chrisdoble/self-balancing-inverted-pendulum/post/post.pdf

# How I Made a Self-Balancing Inverted Pendulum

Chris Doble
chris@chrisdoble.com

February 2024

## Contents

1 Introduction | 1
2 Equations of Motion | 2
3 Linearisation | 5
4 Stability | 7
5 Control | 7
6 Construction | 9
7 Motor Control | 11
8 Code | 16
9 Conclusion | 16

## 1 Introduction

I recently built a self-balancing inverted pendulum. You can watch a video of it here. (https://www.youtube.com/watch?v=-cd6RuVWI30) If you’ve ever tried to keep something like a broom or a stick upright on your hand you’ll know it can be quite tricky! Gravity’s constantly pulling it down, so if it’s not perfectly vertical it’ll start to fall. The same thing happens to the pendulum but it’s connected to a cart which is programmed to move left and right in a way that keeps the pendulum upright.
In this document I’ll explain how I built it. We’ll start by deriving the system’s equations of motion, then we’ll linearise them so we can make use of some tools from linear control theory. Those tools will help us determine if the system is stable and how to control it. We’ll talk about the physical construction of the system and how that integrates with the mathematical model. Finally we’ll talk about the code that controls it.

1

## 2 Equations of Motion

If we want to control this system we need to know how it behaves, so let’s derive its equations of motion. First we need to define our coordinate system and variables in a diagram:

x
m1

m2

l

θ

x

y

We have a cart of mass m1. Its x position is measured from some origin point and it can only move along the x-axis. The cart is connected to a simple pendulum of length l and mass m2 and it’s at an angle θ from vertical.
With that out of the way, now we can calculate the Lagrangian of the system. The Lagrangian is defined as the difference between the system’s kinetic and potential energies
L = T − U.

Starting with the cart, its kinetic energy is

Tcart =

1
2

m1v

2

but because it can only move along the x-axis its velocity has no y component and this is equivalent to

Tcart =

1
2

m1x˙

2

where ˙x is the derivative of x with respect to time, i.e. the cart’s x velocity. As for the cart’s potential energy, it can’t move up or down so its gravitational potential energy can’t change and there’s no springs or anything involved so we might as well set it to
Ucart = 0.

Next, the pendulum. Because it’s joined to the cart its x coordinate changes as the cart moves, and both of its coordinates change as it rotates. That being the case, its coordinates are

X = x − lsin θ
Y = l cos θ.

2

Differentiating them with respect to time gives the x and y components of the pendulum’s velocity

X˙ = ˙x − l

˙θ cos θ

Y˙ = −l

˙θ sin θ.

Using the Pythagorean theorem we can combine these to find the squared mag-nitude of its velocity

V

2 = X˙ 2 + Y˙ 2

= ( ˙x − l

˙θ cos θ)
2 + (−l

˙θ sin θ)
2

= ˙x

2 − 2l

˙θx˙ cos θ + l
2 ˙θ
2

and we can use this to find its kinetic energy

Tpendulum =

1
2

m2V

2

=

1
2

m2( ˙x

2 − 2l

˙θx˙ cos θ + l

2 ˙θ
2
).

Unlike the cart, the pendulum’s potential energy can change — when it rotates it moves up and down so its gravitational potential energy changes. If we say its potential energy is 0 when it’s horizontal (θ = π/2), then we can define its potential energy to be

Upendulum = m2gy
= m2gl cos θ

where g is acceleration due to gravity.
Combining all of those energies and rearranging gives us our Lagrangian

L = T − U

= Tcart + Tpendulum − Ucart − Upendulum

=

1
2

m1x˙

2 +

1
2

m2( ˙x

2 − 2l

˙θx˙ cos θ + l

2 ˙θ
2
) − m2gl cos θ

=

1
2

(m1 + m2) ˙x

2 +

1
2

m2(l

2 ˙θ
2 − 2l

˙θx˙ cos θ) − m2gl cos θ.

Now that we have it we can apply the Euler-Lagrange equation to each of the system’s two coordinates θ and x. For θ we get

0 =

∂L
∂θ −

d
dt

∂L
∂ ˙θ

= m2l

˙θx˙ sin θ + m2glsin θ −

d
dt(m2l

2 ˙θ − m2lx˙ cos θ)

= m2l

˙θx˙ sin θ + m2glsin θ − m2l

2 ¨θ + m2lx¨ cos θ − m2l

˙θx˙ sin θ

= g sin θ − l

¨θ + ¨x cos θ

3

and for x we get

0 =

∂L
∂x −

d
dt

∂L
∂x˙

= −

d
dt[(m1 + m2) ˙x − m2l

˙θ cos θ]

= −(m1 + m2)¨x + m2l

¨θ cos θ − m2l

˙θ
2
sin θ.

Rearranging these two equations and solving for ¨θ and ¨x gives us our equations of motion

¨θ =

(m1 + m2)g sin θ − m2l

˙θ
2
cos θ sin θ
l(m1 + m2) − m2l cos² θ

x¨ =

m2g sin 2θ − 2m2l

˙θ
2
sin θ
2m1 + m2 − m2 cos 2θ

Now that we have them how do we know they’re correct? One way would be to solve them for θ and x and see if their predictions are reasonable. I certainly don’t know how to solve them analytically, but we can solve them numerically. Here (https://github.com/chrisdoble/self-balancing-inverted-pendulum/blob/master/notebooks/uncontrolled.nb) is a Mathematica notebook that does just that. First it defines some constants like gravity, the length of the pendulum, etc. followed by the initial conditions for the simulation. It solves the equations of motion numerically and generates a plot of the solutions. The following shows a pendulum being released from 30◦

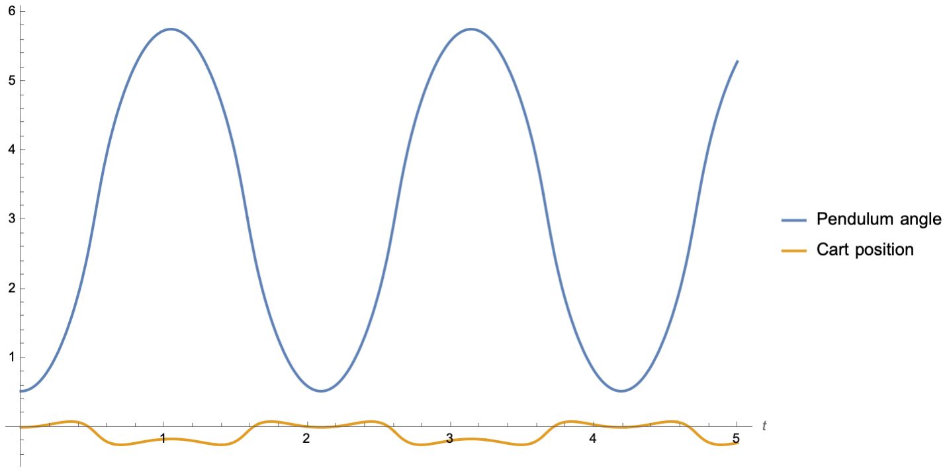
[picture p13: figure]

The pendulum swings back and forth as we expect, but interestingly it also causes the cart to move. The notebook also generates an animation which you can see here. (https://github.com/chrisdoble/self-balancing-inverted-pendulum/blob/master/post/images/uncontrolled.gif)

4

## 3 Linearisation

These equations look good, but they’re quite complicated so it might be difficult to analyse the stability of the system and determine how to control it. Can we simplify them at all? One approach is to linearise them.
Linearising a function means finding a linear approximation of it at a particular point. For example, if we graph a function y = f(x) and we want to linearise it at x = 1, we evaluate it at the point to find its y coordinate, and we evaluate its derivative at the point to find its slope. Using this information we can plot a new function that passes through the point and extends the slope in both directions. It’s a line. Near the point the line does a pretty good job of approximating the function. As you move away it doesn’t do as good of a job, but if you only care about the region around the point that’s fine.


In the case of the pendulum, our goal is to keep the cart in the middle of the track, the pendulum upright, and neither the cart nor the pendulum moving. In other words, we want all four variables θ,

˙θ, x, and ˙x to be 0. The further they are from 0 the less likely it is we’ll be able to recover and we might have to accept that the pendulum’s going to fall over or hit the end of the track. If they’re always going to be near 0 then it sounds like we can tolerate the approximation error and linearisation might work for us!
So how do we linearise our equations of motion? First, let’s combine them into one vector-valued function

¨θ
x¨

= f(θ, ˙θ) = "

(m1+m2)g sin θ−m2lθ˙²
cos θ sin θ
l(m1+m2)−m2l cos² θ
m2 sin 2θ−2m2lθ˙²
sin θ
2m1+m2−m2 cos 2θ

Let’s also define the state vector x to be a column matrix describing the state

5

of the system

x =

θ
˙θ
x
x˙

With this definition we can change our function to accept the state vector x

¨θ
x¨

= f(x) = "

(m1+m2)g sin θ−m2lθ˙²
cos θ sin θ
l(m1+m2)−m2l cos² θ
m2 sin 2θ−2m2lθ˙²
sin θ
2m1+m2−m2 cos 2θ

If we include ˙θ and ˙x in the output you can see that the function now returns the derivative of x

˙θ
¨θ
x˙
x¨

= f(x) =

˙θ

(m1+m2)g sin θ−m2lθ˙²
cos θ sin θ
l(m1+m2)−m2l cos² θ
x˙
m2 sin 2θ−2m2lθ˙²
sin θ
2m1+m2−m2 cos 2θ

x˙ = f(x) =

˙θ

(m1+m2)g sin θ−m2lθ˙²
cos θ sin θ
l(m1+m2)−m2l cos² θ
x˙
m2 sin 2θ−2m2lθ˙²
sin θ
2m1+m2−m2 cos 2θ

The general equation to linearise a vector-valued function like this at a particular point p is
f(x) ≈ f(p) + Df|p(x − p).

As mentioned before we want to linearise our function at the point where all the elements of x are 0. That means p is the zero vector and the equation becomes

f(x) ≈ f(0) + Df|0(x − 0).

Looking at the elements within f(x) you can see that at this point ˙θ = 0 so the first element is 0. sin θ = 0 so the second element is 0. ˙x = 0 so the third element is 0. Finally, sin θ = 0 and sin 2θ = 0 so the fourth element is 0. So f(x) evaluated at the point p = 0 is also the zero vector and we can remove it from our linearised function

f(x) ≈ Df|0x.

The remaining term is the Jacobian matrix of our function evaluated at the point p = 0. It plays the same role the derivative did in the previous two-dimensional example — when you multiply it by a displacement vector x it tells you how much each component of the function differs from the point at which it was linearised. It’s like extending the slope in each dimension. If we actually

6

evaluate it we get a matrix that we’ll call A and the final linearised version of our function is

x˙ = Ax =

0 | 1 0 0
g(m1+m2) lm1 | 0 0 0
0 | 0 0 1
gm2 m1 | 0 0 0

x.

I’ve intentionally skimmed over some details in this section to keep things short. If you’d like to learn more about linearising nonlinear systems and when it’s actually valid to do that, these two videos from Steve Brunton are great: Lin-earizing Nonlinear Differential Equations Near a Fixed Point, (https://www.youtube.com/watch?v=RCWkzzLgwf0) and The Hartman-Grobman Theorem, Structural Stability of Linearization, and Stable/Unstable Manifolds. (https://www.youtube.com/watch?v=vRaUSnB7qNw)

## 4 Stability

Now that we have a linearised version of our equations of motion we can apply some tools from linear control theory. One of those tools is stability analysis. This tells us that if any of the eigenvalues of our A matrix have a positive real component, the system is unstable. Our four eigenvalues are

0, 0, −

s
g(m1 + m2)
lm1

, and s
g(m1 + m2)
lm1

All of the values under that radical are positive, so the second two eigenvalues are real and the last eigenvalue is positive which tells us what we already know: the pendulum’s going to fall over.

## 5 Control

I mentioned earlier that the cart moves left and right to keep the pendulum upright. A more formal of saying that is: we can say we apply a force F on the cart in the x direction. We can recalculate our equations of motion to include this force, the only difference is we apply d’Alembert’s principle to the Euler-Lagrange equation for the x coordinate and equate it to F. This results in the following updated equations of motion where I’ve hidden some terms so we can focus on the coefficients of F

¨θ = f(θ, ˙θ) + | cos θ l(m1 + m2) − lm2 cos² θ
F
x¨ = g(θ, ˙θ) + | 2 2m1 + m2 − m2 cos 2θ
F.

7

Again, our goal is for θ to be close to 0 so we can use the small angle approximation where cos θ ≈ 1. That simplifies these equations to

¨θ = f(θ, ˙θ) + 1
lm1

F

x¨ = g(θ, ˙θ) + 1
m1

F.

If we use the coefficients of F to create a new matrix B and substitute this into our linearised equations of motion we get

x˙ = Ax + BF

=

0 | 1 0 0
g(m1+m2) lm1 | 0 0 0
0 | 0 0 1
gm2 m1 | 0 0 0

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
Another useful tool from control theory is the concept of controllability. A system is said to be controllable if it’s possible to move it into any state you want using only its inputs. In our case, the only input is F — is that enough to control the system? It is if the rank of the controllability matrix equals the dimension of the state space

rank(C) = rank(-

B AB A²B · · · A

n−1B
)

= n.

If we perform this calculation using our A and B matrices we get the value 4. This is the dimension of our state vector which means we are able to control the system using only the force F.
Now we have a way to control the system, but how do we choose F? We want it to be a function of the state of the system — for example, if the pendulum is close to vertical we want to apply a small force but if it’s far from vertical we want to apply a larger force. This suggests we could define it as a row matrix K times the state vector x
F = Kx.

Conventionally this is written with a minus sign

F = −Kx.

If we substitute this into our linearised equation of motion we get

x˙ = Ax − BKx
= (A − BK)x.

This looks very similar to the original equation except A has been replaced by A − BK. If we can choose K in such a way that the eigenvalues of A − BK don’t have positive real components, the system will be stable.

8

So how do we choose K? One approach is to use the Linear Quadratic Reg-ulator algorithm. I don’t completely understand how this works, but thankfully there’s a Mathematica function that does. It accepts our A and B matrices plus two additional matrices that define how much it “costs” to apply a force to the cart and for each variable to differ from 0. For example, if we don’t want to use much electricity running the motor we could set the force cost high and the resulting K matrix would try to minimise its use. Or if we don’t want the cart to move far from the centre of the track we could set the x cost high and the matrix would try to keep it near 0, possibly at the expense of another variable like the pendulum angle.
Here (https://github.com/chrisdoble/self-balancing-inverted-pendulum/blob/master/notebooks/controlled.nb) is a Mathematica notebook that calculates the K matrix and generates a plot of a pendulum controlled by it. The following shows a pendulum being released from 30◦ with all costs set to 1.


The cart quickly moves to the left to prevent the pendulum from falling, continues moving until the pendulum is slightly angled to the right, then slowly moves to the right until the cart is in the middle of the track and the pendulum is vertical. The notebook also generates an animation which you can see here. (https://github.com/chrisdoble/self-balancing-inverted-pendulum/blob/master/post/images/controlled.gif)

## 6 Construction

That’s enough math for now. Let’s talk about the physical construction.
At its core are two steel rods that the cart slides along on linear bearings. The cart itself and the two ends are 3D printed in PLA.

9


On the bottom of the cart are two extensions that the timing belt connects to. The timing belt comes from one side of the cart, over the ilder pulley, all the way over to the timing pulley, and back to the other side of the cart. This means that when the timing pulley rotates, the cart moves.


The timing pulley is on an axle that’s connected to an incremental rotary encoder so we can measure the position of the cart. On the other side of the axle is a 3D printed 5:1 gear train that’s connected to a DC motor. I had to add the gear train because I bought a 24V motor which ended up being overkill for this project and I needed a way to reduce the RPM. On top of the housing is a limit switch which is primarily used to zero the cart position on startup, but it’s also used to kill the motor if the cart gets too close to the end.

10


The pendulum itself is a long steel rod connected to a shorter steel rod with a 90° clamp. The shorter rod runs through some bearings and to another incremental rotary encoder that lets us measure the angle of the pendulum.


The system is all controlled by an Arduino Uno, the motor is controlled by a motor driver which is connected to a 24V power supply, and everything is connected via a breadboard.

## 7 Motor Control

Great! We have our control algorithm and we’ve built the physical system, but there’s still one missing piece. The control algorithm tells us the force F to apply to the cart, but the Arduino controls the cart via a motor, and it controls the motor via a voltage. How do we convert a force into a voltage? We’ll need an equation for that.

R | L

−

+ Vmotor

We can model the electrical properties of a DC motor using this simple circuit. Vin is the voltage applied to the motor, R is the resistance of its windings, L is the inductance of its windings, and Vmotor is the back emf generated as the motor is spinning. Applying Kirchoff’s voltage law to this circuit gives

Vin − IR −

dI
dt L − Vmotor = 0.

If we assume the back emf is proportional to the motor’s angular velocity ω this becomes
Vin − IR −

dI
dt L − a1ω = 0

11 where a1 is a proportionality constant.
We can model the mechanical properties of a DC motor by treating it as a rotating cylinder. It experiences a torque from the motor τm and a resistive torque τr from back emf, friction, etc. This gives an equation of motion

τm − τr = Jω˙

where J is the cylinder’s moment of inertia. If we assume the torque from the motor is proportional to the current flowing through it and the resistive torque is proportional to the cylinder’s angular velocity this becomes

a2I − a3ω = Jω˙

where a2 and a3 are proportionality constants.
We can solve this equation of motion for I

I =

1
a2

(a3ω + Jω˙)

and take the derivative with respect to time to find

dI
dt =

1
a2

(a3ω˙ + Jω¨).

If we substitute these into the electrical equation and collect constants we get

b1ω¨ + b2ω˙ + b3ω + Vin = 0

which has the general solution

ω = c1Vin + c2e

c3t + c4e

c5t

Taking a step back, what does this equation represent? It tells us how the motor’s angular velocity changes over time if we apply a constant voltage Vin. Can we use our intuition about how the motor behaves to give us any clues about these constants? First of all, we probably don’t need two exponential terms, so let’s assume c4 is 0

ω = c1Vin + c2e

c3t

Next, the motor’s angular velocity is 0 at t = 0 so c2 = −c1Vin

ω = c1Vin(1 − e

c3t
).

We also know that if we apply a constant voltage the motor’s angular velocity will increase quite quickly but then resistive forces cause it to stabilise around a steady state value. If that’s the case c3 must be negative, otherwise the angular velocity would decrease exponentially forever. Finally, if we multiply both sides of the equation by the radius of the timing pulley we get the velocity of the

12 cart instead of the angular velocity of the motor which will make things a little easier for us later
v = d1Vin(1 − e

−d2t
), d2 > 0.

This is the general equation for the cart’s velocity over time at particular input voltage. In order to use it for our pendulum we need to find the values of the constants d1 and d2 for our motor. We can do this by collecting data on the motor’s behaviour at different voltages and fitting our model to that data. Here (https://github.com/chrisdoble/self-balancing-inverted-pendulum/blob/master/notebooks/motor.nb) is a Mathematica notebook that does just that. First it plots cart’s velocity over time for 14 different voltages, some forwards, some backwards. Other than a blip at around 0.45 s it looks as we would expect.

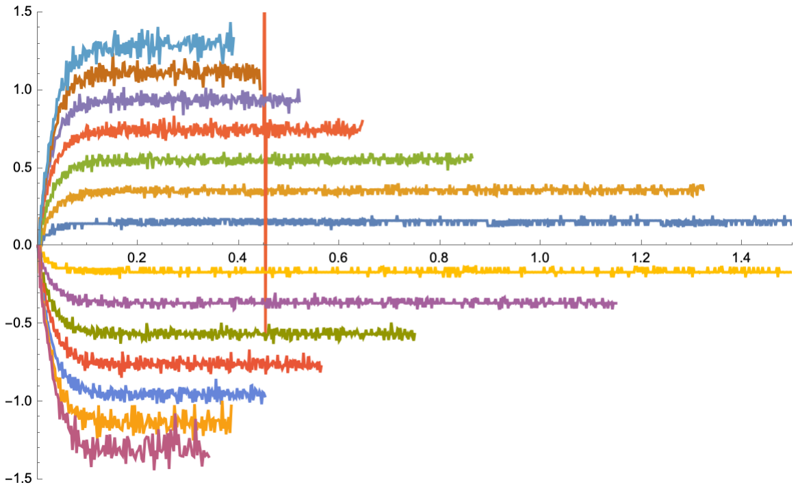
[picture p14: figure]

Next it uses Mathematica’s FindFit function to find the best values of d1 and d2 to fit our velocity equation to the dataset and plots the result on top. It’s a pretty good fit!

13

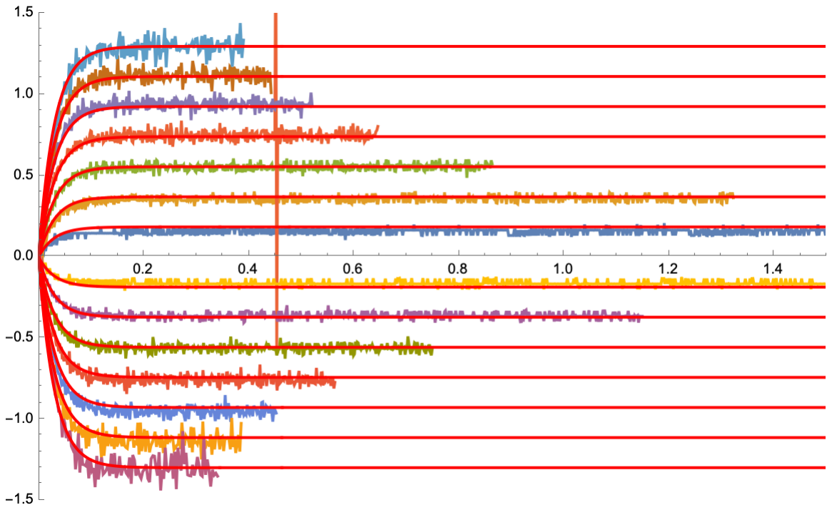
[picture p15: figure]

We now have an equation for the cart’s velocity over time but it’s not very useful. Firstly because it assumes a constant voltage and we’re going to be changing the voltage to move the cart back and forth. Secondly, we’re trying to find an equation to convert a force into voltage and this equation doesn’t involve force at all.
How can we fix this? Newton’s second law tells us that F = ma. If we can find an equation for the acceleration of the cart based on the input voltage, we could rearrange Newton’s second law to get the voltage in terms of the force which is what we’re looking for.
Let’s take the derivative of our velocity equation with respect to time

a = d1d2Vine

−d2t

This looks promising, but it still assumes a constant voltage and what value would we use for t? Let’s keep looking.
Earlier we found a time-indepdendent equation for the angular velocity of the motor
b1ω¨ + b2ω˙ + b3ω + Vin = 0.

If we assume that the first term is small and can be ignored

b2ω˙ + b3ω + Vin = 0,

multiply by the radius of the timing pulley

b2a + b3v + RVin = 0,

rearrange, and collect constants we get an equation for the cart’s acceleration that doesn’t involve time
a = k1v + k2Vin.

14

We don’t know the values of these constants k1 and k2 but we can find them by equating this equation with the other one for the cart’s acceleration

d1d2Vine

−d2t = k1v + k2Vin

= k1d1Vin(1 − e

−d2t
) + k2Vin

= (k1d1 + k2)Vin − k1d1e

−d2t

so k1 = −d2 and k2 = d1d2. Finally we have a time-independent equation for the cart’s acceleration
a = d1d2Vin − d2v.

Is this equation correct? One way to check is to integrate it numerically and see if the result matches the data we collected. The Mathematica notebook generates the following plot which looks pretty good.

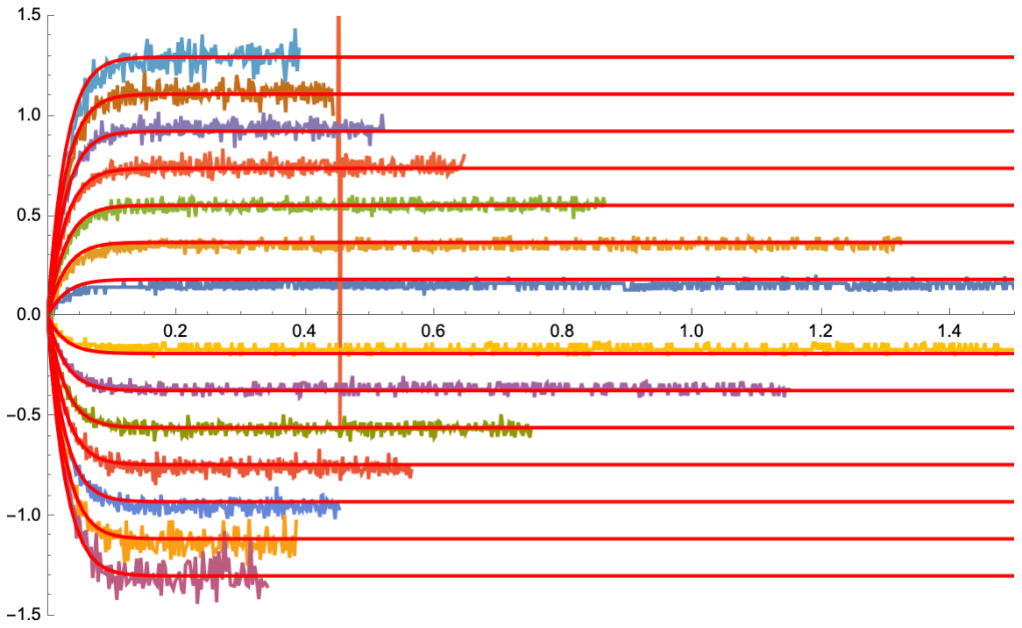
[picture p16: figure]

Using Newton’s second law we can multiply the cart’s mass and acceleration to find the applied force

F = m2(d1d2Vin − d2v)

and we can rearrange to find the voltage required to apply that force

Vin =

1
d1
v +

F
d2m2

So the control algorithm tells us what force to apply and this equation tells us what voltage to apply. We’re ready to start coding!

15

## 8 Code

Here (https://github.com/chrisdoble/self-balancing-inverted-pendulum/blob/master/sketch/sketch.ino) is the code that runs the system. One of its most important jobs is to observe signals from the rotary encoders so we know the motor and pendulum angles. That’s achieved with two interrupt handlers. They’re called when the signal from a rotary encoder changes, they calculate the angle change, and update the appropriate variable.
The rest of the system is a big state machine. It moves through a series of initialisation states, starts running, and finally gets killed for one reason or another.
On startup we don’t know the position of the cart, so in the first state the cart moves to the right until it’s pressing the limit switch. At that point we know where the cart is which lets us zero the cart position and motor angle variables.
Next, the cart moves to the middle of the track which is where we want it to be when it starts running.
We also need to zero the pendulum angle. The pendulum might still be swinging from the cart’s movement, so we wait until it’s still, assume it’s pointing down due to gravity, and zero the pendulum angle variable. This does mean that down is considered zero instead of up, but that’s fixed in the next state. The user rotates the pendulum until it’s near upright, we offset the pendulum angle variable so up is considered zero, and we start running.
If the cart gets too close to either end of the track or the pendulum angle becomes too great, we assume we’re not going to be able to recover, and kill the system. You can also kill it manually by pressing the limit switch.
The last significant part of the code is calculating the cart’s velocity and the pendulum’s angular velocity. On each iteration of the main loop we record the cart’s position, the pendulum’s angle, and the time. We store the last 10 of these values and calculate the velocities as the difference between the most recent value and the oldest value, divided by the difference in their times. I was originally using lower resolution rotary encoders and this method didn’t work very well. I tried more complicated numerical differentiation approaches but they were all quite slow. Upgrading to higher resolution rotary encoders let me use this faster and simpler method.

## 9 Conclusion

And that’s how I built my self-balancing pendulum! The 3D models, code, notes, and everything else are available on GitHub here. (https://github.com/chrisdoble/self-balancing-inverted-pendulum) Please let me know if you have any feedback or questions.

16
