chrisdoble/self-balancing-inverted-pendulum/notes/notes.pdf

## Contents

1 Equations of Motion | 1
2 Linearization, Stability, and Controllability | 3
3 Motor Control | 4

## 1 Equations of Motion

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
- A cart of mass M is constrained to move along the x axis with its dis-tance from an arbitrary point on the x axis denoted x. A driving force of magnitude F is applied to the cart in the x direction. A simple pendulum consisting of a mass m and a massless rod of length l is connected to the cart with its angle from the positive y axis denoted θ.
- The kinetic energy of the cart is

Tcart =

1
2

Mx˙

2
- The x and y coordinates of the pendulum are

X = x − lsin θ
Y = l cos θ,

thus its x and y velocities are

X˙ = ˙x − l

˙θ cos θ

Y˙ = −l

˙θ sin θ

1

and its kinetic energy is

Tpendulum =

1
2

mv²

=

1
2

(X˙ 2 + Y˙ 2
)

=

1
2

m[( ˙x − l

˙θ cos θ)
2 + (−l

˙θ sin θ)
2
]

=

1
2

m( ˙x

2 − 2lx˙

˙θ cos θ + l
2 ˙θ
2
).
- The total kinetic energy of the system is

T = Tcart + Tpendulum

=

1
2

(m + M) ˙x

2 +

1
2

m(l

2 ˙θ
2 − 2lx˙

˙θ cos θ).

- The potential energy of the system is equal to the gravitational potential energy of the pendulum. If its potential energy is 0 when θ =

π
2

then

U = mgl cos θ.

- The Lagrangian of the system is

L = T − U

=

1
2

(m + M) ˙x

2 +

1
2

m(l

2 ˙θ
2 − 2lx˙

˙θ cos θ) − mgl cos θ.

- By d’Alembert’s principle the generalized forces associated with the θ and x coordinates are 0 and F, respectively.
- The Euler-Lagrange equation for the θ coordinate is

d
dt

∂L
∂ ˙θ

−

∂L
∂θ = 0

d
dt(ml² ˙θ − mlx˙ cos θ) − mlx˙

˙θ sin θ − mglsin θ = 0

l

¨θ − x¨ cos θ − g sin θ = 0.

- The Euler-Lagrange equation for the x coordinate is

d
dt

∂L
∂x˙

−

∂L
∂x = F

d
dt[(m + M) ˙x − ml ˙θ cos θ] = F

(m + M)¨x − ml¨θ cos θ + ml ˙θ
2
sin θ = F.

2

- Solving these equations for ¨θ and ¨x gives

¨θ =

(m + M)g sin θ + F cos θ − ml ˙θ
2
cos θ sin θ
l(m + M) − ml cos² θ

and

x¨ =

2F + mg sin 2θ − 2ml ˙θ
2
sin θ
m + 2M − m cos 2θ

## 2 Linearization, Stability, and Controllability

- The state vector for this system is

θ
˙θ
x
x˙
- The fixed point about which the system will be linearized is

0
0
0
0
- The A matrix is equal to the Jacobian matrix evaluated at the fixed point

A =

0 1 0 0

g(m+M)
lM | 0 0 0
0 | 0 0 1
gm
M 0 0 0
- The non-zero eigenvalues of A are

±

r
g(m + M)
lM .

Because one of these has a positive real part the system is unstable.

- Rearranging the equations of motion to find the coefficients of F gives
¨θ = f(θ, ˙θ) + | cos θ
l(m + M) − ml cos² θ

F

and
x¨ = g(θ, ˙θ) + | 2
m + 2M − m cos 2θ

F.

3

Using the small angle approximation for cos gives

¨θ = f(θ, ˙θ) + 1
lM F

and
x¨ = g(θ, ˙θ) + 1
M

F

resulting in the B matrix

0
1
lM
0
1
M
- The controllability matrix

C =

B AB A²B A³B

has full rank (4) so the system is controllable via the force F on the cart.

- The ideal state feedback gains matrix K can be determined using Mathe-matica’s LQRegulatorGains function.
- Thus, the force to apply to the cart when the system is in state x is

F = u = −Kx.

## 3 Motor Control

- Using the equations above we can calculate the force to apply to the cart when the system is in a given state. However, the motor (which applies a force to the cart) is controlled via pulse-width modulation (PWM) and it’s not clear what force results from a particular duty cycle.
- The motor can be electrically modelled by the circuit
R | L

−

+ Vmotor

where Vin is the (effective) voltage delivered to the motor via PWM, R is the resistance of the motor’s windings, L is the inductance of the motor’s windings, and Vmotor is the back EMF generated as the motor is spinning.

4

- If we assume that the back EMF generated by the motor is proportional to its angular velocity, i.e. Vmotor = Kbω, then Kirchoff’s voltage law gives

Vin − IR −

dI
dt L − Vmotor = 0

Vin − IR −

dI
dt L − Kbω = 0.
- The motor can be mechanically modelled as a rotating cylinder with equation of motion

τm + τr = Jα
KtI − bω = Jα

where τm is the torque due to the motor which is proportional to the current, τr is the resistive torque due to air resistance, friction, etc. which is proportional to the angular velocity ω, J is the moment of inertia, and α is the angular acceleration.

- Rearranging the last equation for I we find

I =

1
Kt

(bω + Jα)

and
dI
dt =

1
Kt

(bα + Jα˙).

- Substituting this into the electrical equation above gives

Vin −

R
Kt

(bω + Jα) −

L
Kt

(bα + Jα˙) − Kbω = 0

Vin −

bR
Kt

+ Kb

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
α˙ = 0

or
Aω¨ + Bω˙ + Cω + Vin = 0

where A, B, and C are constants.

- The general solution to this equation is

ω = AVin + BeCt + DeEt

where A, B, C, D, and E are different constants from above.

- The equation can be simplified by assuming D = 0

ω = AVin + BeCt

5

- In reality ω quickly changes from 0 to some equilibrium value that has the same sign as Vin. That being the case, we know:

– C must be negative otherwise ω would increase without bound,

– A must be positive as the equilibrium value has the same sign as Vin, and
– B = −AVin because ω(0) = 0.

Finally, the equation can be multiplied by the radius of the timing pulley R to give the velocity of the cart v. This gives

v = AVin(1 − e

−Bt)

where A, B > 0 are constants that can be determined from experimental data.

- Differentiating this equation with respect to time gives

a = ABVine

−Bt

which can be equated with the time-independent equation for a = Rω˙

ABVine

−Bt = CVin + Dv

= CVin + D[AVin(1 − e

−Bt)]

= (AD + C)Vin − ADVine

−Bt

From this we can see AB = −AD or D = −B and AD+C = 0 or C = AB. Once A and B are determined from experimental data we can determine C and D and thus the time-independent equation for a.

- The time-independent equation for a can be multiplied by the mass of the cart M to find the force on the cart F. This equation can then be rearranged to find the voltage Vin required to exert a force F on the cart when it has velocity v

a = CVin + Dv
F = M(CVin + Dv)

Vin =

1
C
F
M

− Dv

This equation bridges the control equations of section 2 and the motor equations of this section.

6
