chrisdoble/self-balancing-inverted-pendulum/notes/control_bootcamp.pdf

This document contains my notes on Steve Brunton’s Control Bootcamp video series. (https://www.youtube.com/playlist?list=PLMrJAkhIeNNR20Mz-VpzgfQs5zrYi085m) Each section corresponds to the video of the same title.

## Contents

1 Overview | 1
2 Linear Systems | 2
3 Stability and Eigenvalues | 4
4 Linearizing Around a Fixed Point | 5
5 Controllability | 6
6 Controllability, Reachability, and Eigenvalue Placement | 7
7 Controllability and the Discrete-Time Impulse Response | 7
8 Degrees of Controllability and Gramians | 7
10 Cayley-Hamilton Theorem | 8

### 14 Linear Quadratic Regulator (LQR) Control for the Inverted

Pendulum on a Cart | 8

## 1 Overview

- Passive controls attempt to control a system passively, i.e. they are built into the system and don’t vary based on observations of the system.
- Active controls attempt to control a system actively, i.e. they change their behaviour based on observations of the system.
- Open-loop controllers don’t observe the output of the system — their inputs are predetermined. One downside of this approach is that you may unnecessarily input energy into the system when it already has the desired output.
- Closed-loop controllers observe the output of the system to determine their inputs. They have several benefits over open-loop controllers:

– They handle uncertainty in the system, e.g. if you don’t always know how the system will respond, or if your model isn’t completely accurate.

1

– They handle disturbances in the system, e.g. if someone pushes a self-balancing inverted pendulum. It may not be possible to account for these in the model.

– They can be more energy efficient than open-loop controllers, i.e. they don’t have the downside mentioned above.

- The mathematical model used in this course is a state-space based system of linear differential equations

x˙ = Ax

where x is the state vector — a vector containing all the system’s values of interest — and x˙ are their rates of change at a time t.

- The solution to the above equation is

x(t) = e

Atx(0)

and the eigenvalues of A can be used to determine the stability of the system, e.g. if they all have negative real components the system is stable.

- Control is introduced to the system by modifying the equation to

x˙ = Ax + Bu

where B is a coefficient matrix and u is the input to the system.

- If we make the input to the system

u = −Kx

then

x˙ = Ax − BKx
= (A − BK)x

and now it is the eigenvalues of A − BK that determine the stability of the system, i.e. we can make an unstable system stable by appropriate choice of inputs.

## 2 Linear Systems

- The solution to the linear system of differential equations

x˙ = Ax

is
x(t) = e

Atx0

2

where

e

At =

X∞

k=0

(At)

k
k!

= I + At +

A

2
t

2
2! +

A

3
t

3
3! + . . .
- If a matrix A has eigenvalues λ1, . . . , λn and eigenvectors k1, . . . , kn then

AT = TD

or
T

−1AT = D

where
T =
k1 | · · · | kn

and

D =

λ1 | | 0
0 | | λn

- Using the above gives
e

At = Te
DtT

−1

which is simpler because e

Dt
is easy to calculate.
- If we define z to be x transformed to the eigenvector basis, i.e.

x = Tz

and
x˙ = Tz˙

then

z = T

−1x

z˙ = T

−1x˙

= T

−1Ax

= T

−1ATz

= Dz

where D is the diagonal matrix consisting of the eigenvalues of A. The solution to this equation is

z(t) = e

Dt
z0

3

where

e

Dt =

e

λ1t | 0
0 | e λnt

,

i.e. the equations are uncoupled such that

z1(t) = z0,1e

λ1t

zn(t) = z0,ne

λnt
- The equivalence between the original and eigenvector coordinates can be seen by manipulating the solution

x(t) = e

Atx0

= Te

DtT

−1x0

= Te

Dt
z0
= Tz(t).

## 3 Stability and Eigenvalues

- A system x˙ = Ax is stable if and only if all of the eigenvalues of A have negative real parts. This is because the solution is of the form¹

x = Te

DtT

−1x0

where

e

Dt =

e

λ1t | 0
0 | e λnt

and
e

λ1t = e

(a+ib)t = e
ate

ibt

which is only stable if a < 0.

- Sometimes you can make a system stable (i.e. make all the eigenvalues have negative real parts) via the control term Bu.
- In a real-world system, control signals will be sent and observations re-ceived in discrete steps rather than continuously. A variation of the equation that captures this is
xk+1 = Ax˜
k

1See here (https://www.youtube.com/watch?v=nyqJJdhReiA#t=15m15s) for a proof of why eAt = TeDtT⁻¹ .

4

where
A˜ = e
A∆t

In other words,

xk = A˜

k
x0

= (T˜ D˜ T˜

−1
)

kx0

= T˜ D˜

k
T˜

−1
x0

where

D˜

k
=

λ˜k
1 | 0
0 | λ˜k
| n

so the discrete system is stable if the moduli of all the eigenvalues of A˜ are less than or equal to 1.

- Note that the stability criteria of a discrete system (the moduli of of all eigenvalues must be less than 1) differs from that of a continuous system (the real parts of all eigenvalues must be negative) because we’re rais-ing A˜ = e
A∆t
to a power directly rather than exponentiating it so both the real and imaginary components of its eigenvalues contribute to the “radius”

λ

k
n = (a + ib)

k

= (p
a

2 + b

2e

i arctan b
a )

k

=

p
a

2 + b

2

k
e

ik arctan b
a .

## 4 Linearizing Around a Fixed Point

- The Jacobian matrix of a vector-valued function of several variables f : R

n → R

m is defined as

Df =

∂f1
∂x1
- · ·

∂f1
∂xn
∂fm
∂x1
- · ·

∂fm
∂xn

- If x is a point and ∆x is a displacement, both in R n, the Jacobian matrix
can be used to linearize f around x

f(x + ∆x) ≈ f(x) + Df|x∆x.

- To convert a nonlinear system x˙ = f(x) to a linear system x˙ = Ax:

5

1. Find fixed points x such that f(x) = 0.
2. Use the Jacobian matrix to linearize f(x) about x, i.e.

x˙ = f(x)

is approximated by

x˙ = f(x) + Df|x∆x
= Df|x∆x
= A∆x

where A = Df|x. However this is only valid if all eigenvalues of A have a nonzero real part.

## 5 Controllability

- A system with control can be modelled using the equation

x˙ = Ax + Bu

where u is the input to the system.

- If we can completely observe the state of the system, i.e. we have access to all state variables, we can let u = −Kx and thus

x˙ = Ax + Bu
= Ax − BKx
= (A − BK)x

and we can control the eigenvalues/stability of the system via careful choice of K.

- A system is said to be controllable if it’s possible to choose u = −Kx such that the system has any arbitrary eigenvalues and thus the state can be manipulated in any desired way.
- In most cases A (the linearized equations of motion) and B (the effects of various inputs) are predetermined and you only get to control u.
- Some combinations of A and B are controllable and some aren’t. For example,

x˙ = Ax + Bu
x˙ 1
x˙ 2
=
1 0

0 2 x1
x2
+
0
1
u

6

isn’t controllable because ˙x1 = x1 isn’t affected by u. However if B were instead
1 0

0 1

the system would be controllable because u can affect both ˙x1 and ˙x2.

- A system with state space in R
n is controllable if the controllability matrix

C =

B AB A²B · · · A

n−1B

has rank n.

## 6 Controllability, Reachability, and Eigenvalue Placement

- The following are all equivalent:

– The system is controllable.

– It’s possible to arbitrarily place the eigenvalues of the system by careful choice of K.

– The state space is fully reachable, i.e. for any state in R

n there exist
inputs u(t) that result in the system being in that state.

## 7 Controllability and the Discrete-Time Impulse Response

- The first column in the controllability matrix can be thought of as an initial “kick” to the system via the input vector u and each subsequent column can be thought of as the state of the system one time step later. This lets us see which dimensions of the state space can be controlled via input.

## 8 Degrees of Controllability and Gramians

- The Gramian of a system is defined as

Wt =

Z t

0

e

AtBBT
e
AT τ | dτ.

It is real-valued and symmetric so it has positive, real eigenvalues. If you sort the eigenvalues from largest to smallest, the same ordering of the as-sociated eigenvectors is also ordering them from most to least controllable.

7

- The Gramian gives a finer grained answer to the question “Is the system controllable?” than the rank of the controllability matrix — it tells you how controllable it is in different dimsensions of the state space.
- A system is said to be stabilisable if all unstable eigenvectors of A are in the controllable subspace, i.e. it’s OK if a subset of the state vector isn’t controllable providing it’s stable — it will stabilise by itself.

## 10 Cayley-Hamilton Theorem

- The Cayley-Hamilton theorem states that every square matrix satisfies its own characteristic equation, i.e. if you take the characteristic equation

det(A − λI) = 0

λ

n + an−1λ

n−1 + · · · + a2λ
2 + a1λ + a0 = 0

and substitute λ with A, the equation is satisfied.

## 14 Linear Quadratic Regulator (LQR) Control for the Inverted Pendulum on a Cart

- The linear quadratic regulator is a feedback controller that minimises the cost of operating the system.
- The cost is defined as

J =

Z ∞

0

(x

T Qx + u

T Ru) dt

where x is an n×1 state vector, Q is an n×n matrix that determines the cost of a given state vector, u is an q × 1 input vector, and R is a q × q matrix that determines the cost of a given input vector.

- Q can be used to associate a cost with given states, e.g. in the case of an inverted pendulum we could say it is 1 unit cost for every 1 unit distance x is away from its target, or it is 100 unit cost for every radian θ is away from its target.
- Similarly, R can be used to associate a cost with given inputs, e.g. if moving the cart uses a lot of electricity we could define some cost for that.
- The linear quadratic regulator finds a matrix K that adjusts the eigenvalues of the system to minimise the above cost.

8
