chrisdoble/self-balancing-inverted-pendulum/post/images/circuit.pdf

R

L

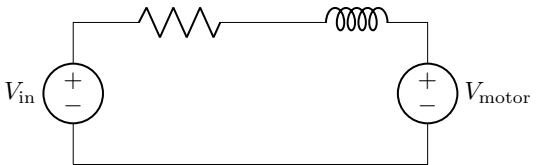
[picture p17: figure]
Vin; Vmotor
