chrisdoble/self-balancing-inverted-pendulum/(commit log)

2023-10-25 Add notes on Control Bootcamp: Linear Quadratic Regulator (LQR) Control for the Inverted Pendulum on a Cart
2023-12-20 Add motor control notes, motor data, and motor model fitting notebook
    [l10.csv, l20.csv, l30.csv, l40.csv, l50.csv, l60.csv, l70.csv, r10.csv]
2023-12-20 Add screenshot of motor data and model plot
2023-12-21 Add configuration routine and "too close to end" termination
    [sketch.ino]
2023-12-21 Flip signs in motor data to match sketch
    [l10.csv, l20.csv, l30.csv, l40.csv, l50.csv, l60.csv, l70.csv, r10.csv]
2023-12-22 Calculate the cart's velocity
2024-01-02 Add pendulum velocity
2024-01-02 Fix initial pendulum angular velocity
    [sketch.ino]
2024-01-02 Change angular velocity to velocity in notes
2024-01-04 Recollect motor data and recalculate motor constants
    [l10.csv, l20.csv, l30.csv, l40.csv, l50.csv, l60.csv, l70.csv, r10.csv]
2024-01-05 Try improving velocity calculation
2024-01-08 Update velocity estimation
2024-01-17 Update to use new rotary encoders
    [l10.csv, l20.csv, l30.csv, l40.csv, l50.csv, l60.csv, l70.csv, r10.csv]
2024-01-19 Fix rotary encoder interrupts
    [sketch.ino]
2024-01-19 Flip origin, reduce maximum speed
    [sketch.ino]
2024-01-31 Add draft of motor control section
2024-01-31 Move data into notebooks directory
    [l10.csv, l20.csv, l30.csv, l40.csv, l50.csv, l60.csv, l70.csv, r10.csv]
2024-02-01 Add axes, move camera
2024-02-04 Simplify motor control section
2024-02-05 Start on motor control animation
